coniferconifer/AIR-BENTO/README.md

## AIR BENTO CO2 and dust monitor by ESP32
## Improve Decision-Making Performance by AIR BENTO
   
### watch CO2 and dust levels at home/car/workplace , vent breathless air
- Winsen MH-Z14A CO2 sensor
- SHARP GP2Y1014AU0F dust/smoke sensor
- Bosch BMP180 pressure sensor GY-68
- Sensirion SHT21 humidity sensor GY-21  
- runs on ESP32 NodeMCU board
- 128x64 mono color OLED display is supported
- works as a MQTT client over WiFi or a BLE device
are packed in BENTO lunch box.

## what's new
- GPIO39->GPIO12 for GP2Y LED control. (GPIO39 does not work for pulse output. ) Sep 16,2018
- GPIO34->GPIO14 for SPI/SD1306. (ESP32 GPIO34-39 can not be used for OUTPUT) Sep 16,2018

- watch dog timer is introduced
- By using the latest Arduino core for ESP32 with BLE , the compiled flash memory reached 
  to 104%, so that #define BLE  at AIR-BENTO is changed to an option by default.<br>
  Update Arduino core for ESP32 WiFi chip , then use "Partition Scheme" in "Tools" menu in Arduino IDE and select "No OTA(large APP)" , 
  this program will fit in the space in case of #define BLE
  
- SHT21 humidity sensor is supported in May/14/2018 by #define HUMIDITY
  (due to i2c error , I replaced Arduino core and SHT21 library to https://github.com/stickbreaker/arduino-esp32 and 
  https://github.com/markbeee/SHT21
- GY-21 board with SHT21
- wirings are changed to use BMP180 as of April/30/2018
- #define DEEPSLEEP for ESP32 deep sleep is supported in May 13,2018

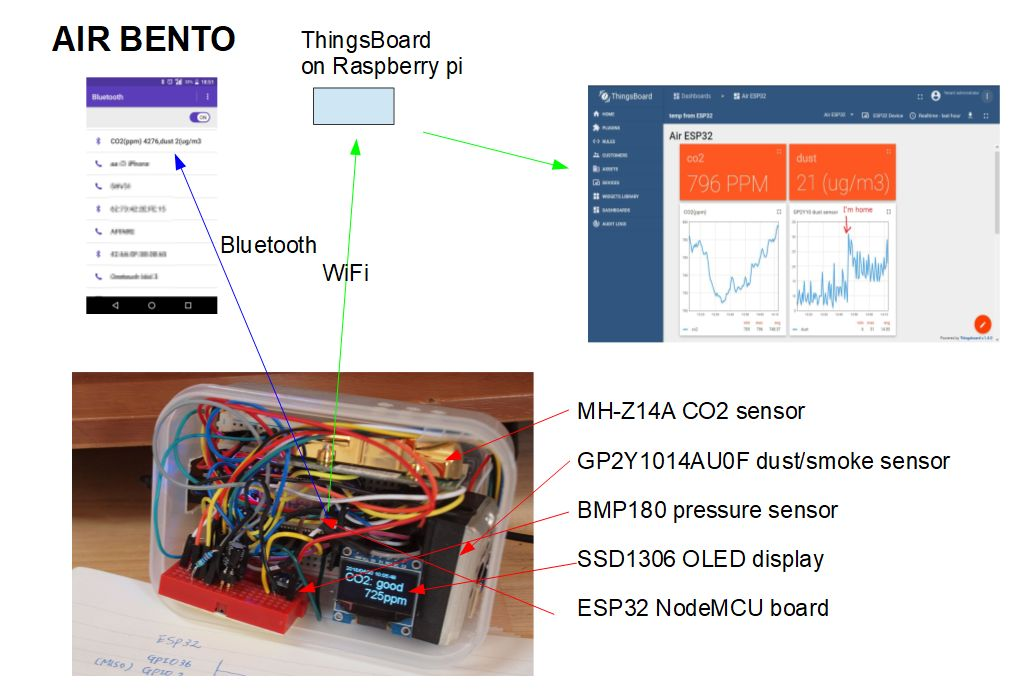
[picture p1: AIR BENTO.jpg]
Fig.1 AIR BENTO


## CO2 sensor Winsen MH-Z14A
- via 9600bps serial port

## Dust sensor SHARP GP2Y1014AU0F or maybe GP2Y1010AU0F
- analog voltage output 0-3.7V 
- Vo output is connected to ESP32 ADC33 port
- internal LED is driven by NPN transister 2N5551 from ~~GPIO39~~ GPIO_NUM_12 (Fig.2)
- max Vo output goes up to 3.7V and exceeds ESP32 max GPIO input voltage spec 3.6V , so Vo is clipped by shotkey diode 1N5819 to protect GPIO33.
  (Fig.2) , but this may be harmful to the last stage amplifier of GP2Y1016AU0F.
  <br>Voltage divider by resisters or another operational amplifier that has 0.8x gain may be better solution for product level quality.

## GY-68 BMP180 pressure sensor (Apr/30/2018)
- connected via I2C (GPIO21 as SDA , GPIO22 as SCL)
- GY-68 BMP180 has 3.3V linear regulator on board and SDA,SCL are pulled up to 3.3V,
  so, I supply 5V to VCC pin. (depending on your hardware) 

## AIR BENTO posts sensor values to MQTT server via WiFi
- ThingsBoard is recommended to visualize data by its dashboard.
  I'm running ThingsBoard on Raspberry pi.

## AIR BENTO broadcasts sensor values as bluetooth device name
- in case there is no WiFi AP available,
Mobile phone users near AIR BENTO can read out sensor values without application.

## License: Apache License v2

## References

### CO2 sensor:

- [MH-Z14A  User's Manual V1.01](http://www.winsen-sensor.com/d/files/infrared-gas-sensor/mh-z14a_co2-manual-v1_01.pdf)

- [MH-Z14A User's ManualV2.4](http://www.winsen-sensor.com/d/files/PDF/Infrared%20Gas%20Sensor/NDIR%20CO2%20SENSOR/MH-Z14%20CO2%20V2.4.pdf)

- [https://revspace.nl/MHZ19](https://revspace.nl/MHZ19)

### SSD1306 OLED display library from 
- [SSD1306 https://github.com/LilyGO/ESP32-OLED0.96-ssd1306](https://github.com/LilyGO/ESP32-OLED0.96-ssd1306)

- [http://esp-idf.readthedocs.io/en/latest/api-reference/peripherals/spi_master.html](http://esp-idf.readthedocs.io/en/latest/api-reference/peripherals/spi_master.html)

### GY-68 BMP180 pressure sensor
- [GY-68 BMP180 http://artofcircuits.com/product/bmp180-digital-barometric-sensor-module-model-gy-68](http://artofcircuits.com/product/bmp180-digital-barometric-sensor-module-model-gy-68)

### BMP180 library
- [https://github.com/adafruit/Adafruit-BMP085-Library](https://github.com/adafruit/Adafruit-BMP085-Library)

### SHT21 library (New!)
- [https://github.com/e-radionicacom/SHT21-Arduino-Library](https://github.com/e-radionicacom/SHT21-Arduino-Library)
- I got i2cCheckLineState() : invalid State sda=0 scl=1  BusInvalidState TwoWire() can't init error by recent compilation
  then , replaced Arduino-esp32 to https://github.com/stickbreaker/arduino-esp32
  and https://github.com/markbeee/SHT21
  Thanks to  https://github.com/espressif/arduino-esp32/issues/464
### PubSubClient
- [https://github.com/knolleary/pubsubclient](https://github.com/knolleary/pubsubclient)

### MQTT server with visiualization tools 
- [https://thingsboard.io/] (https://thingsboard.io/)

### Time display
- public NTP server  [https://developers.google.com/time/](https://developers.google.com/time/)

### Dust sensor:
- [https://media.digikey.com/pdf/Data%20Sheets/Sharp%20PDFs/GP2Y1014AU0F_Spec_2-6-15.pdf](https://media.digikey.com/pdf/Data%20Sheets/Sharp%20PDFs/GP2Y1014AU0F_Spec_2-6-15.pdf)

- technical detail of GP2Y10's analog front end  
[http://www.ti.com/lit/ug/tidub65c/tidub65c.pdf](http://www.ti.com/lit/ug/tidub65c/tidub65c.pdf)
- wiring<br>
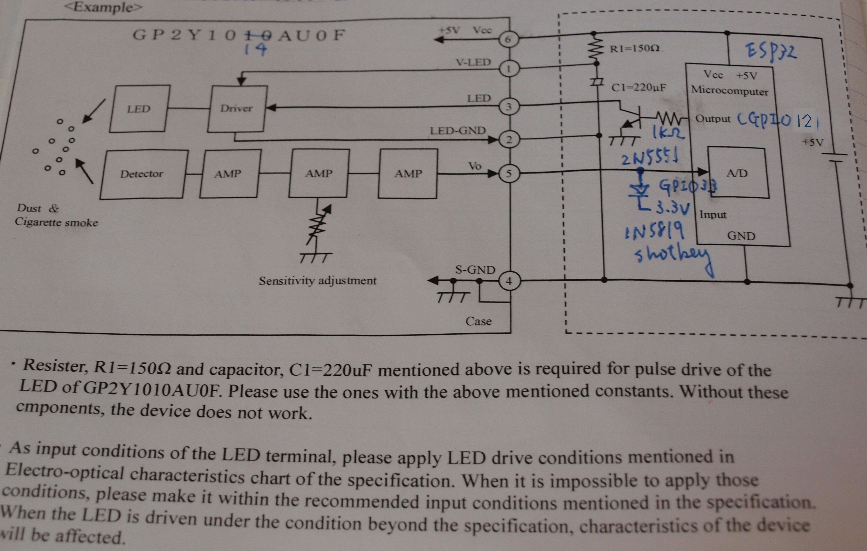
[picture p2: AIRBENTOcircuit.jpg]
Fig.2 dust sensor and ESP32


### trouble shooting:
- Why GPIO33 is used for ADC <br>
  refer to "ADC2 Channel cannot be used when WiFi is in use #440"<br>
  [https://github.com/espressif/arduino-esp32/issues/440](https://github.com/espressif/arduino-esp32/issues/440)

### remaining issues
- ~~WiFi is always ON , not good for longer battery operation.~~

### "Elevated Indoor Carbon Dioxide Impairs Decision-Making Performance"
- [http://newscenter.lbl.gov/2012/10/17/elevated-indoor-carbon-dioxide-impairs-decision-making-performance/](http://newscenter.lbl.gov/2012/10/17/elevated-indoor-carbon-dioxide-impairs-decision-making-performance/)

### "High CO2 Levels in Your Car"
- [https://www.co2meter.com/blogs/news/23987521-high-co2-levels-in-your-car](https://www.co2meter.com/blogs/news/23987521-high-co2-levels-in-your-car)
- AIR-BENTO in the car <br>
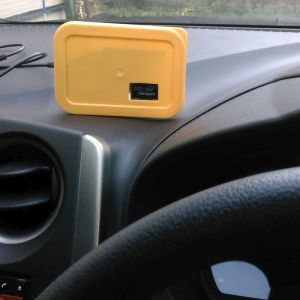
[picture p3: airbentointhecar.jpg]
Fig.3 AIR-BENTO in the car

  
### pulseview by sigrok project is quite useful 
- SHT21 I2C bus observed by CY7C68013A-56 EZ-USB FX2LP USB board<br>
  [https://sigrok.org/wiki/Lcsoft_Mini_Board](https://sigrok.org/wiki/Lcsoft_Mini_Board)
- software logic analyzer<br>
  [https://sigrok.org/wiki/PulseView](https://sigrok.org/wiki/PulseView)<br>
  SHT21 command write<br>
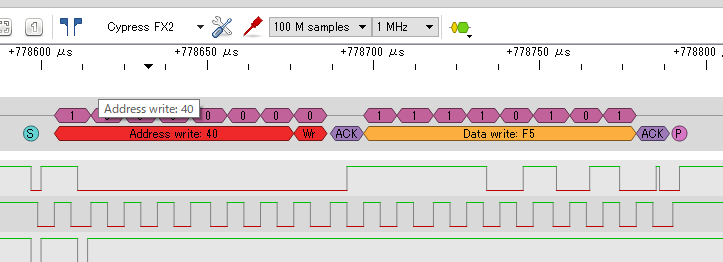
[picture p4: SHT21commandwrite.png]
Fig.4 write
  <br>
  SHT21 command read<br>
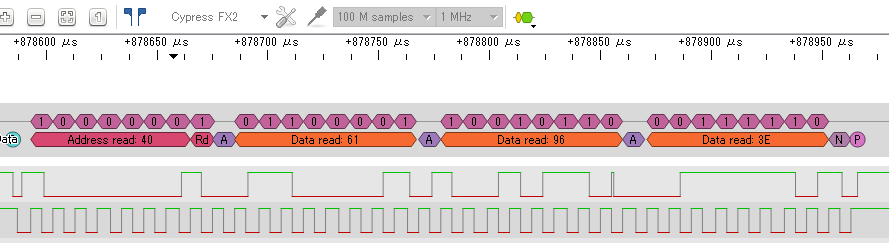
[picture p5: SHT21commandread.png]
Fig.5 read
  <br>

### CO2 measureing may be a brain activity monitor<br>
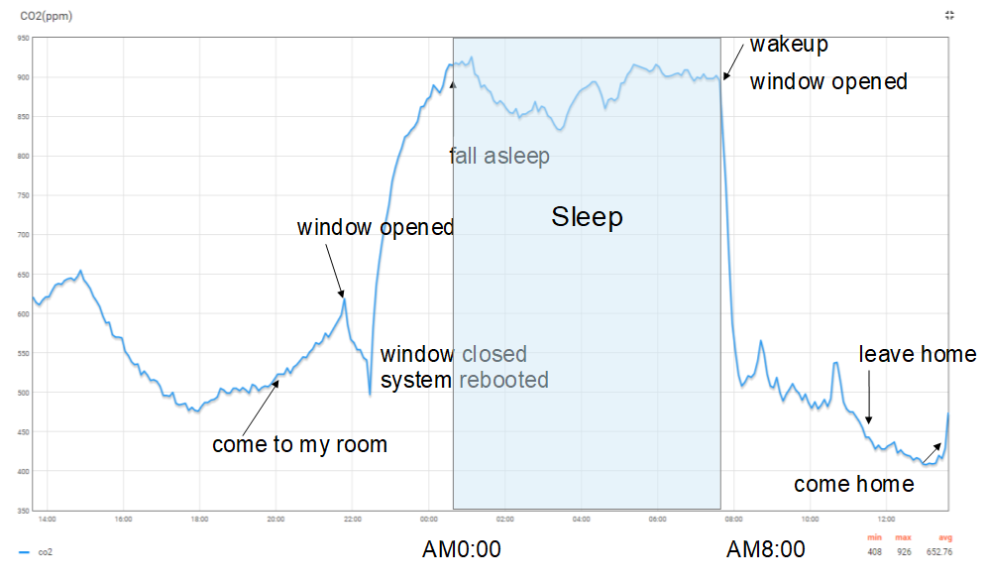
[picture p6: CO2graph.png]
Fig.6 CO2 graph
<br>

### dust sensor detects when I'm home
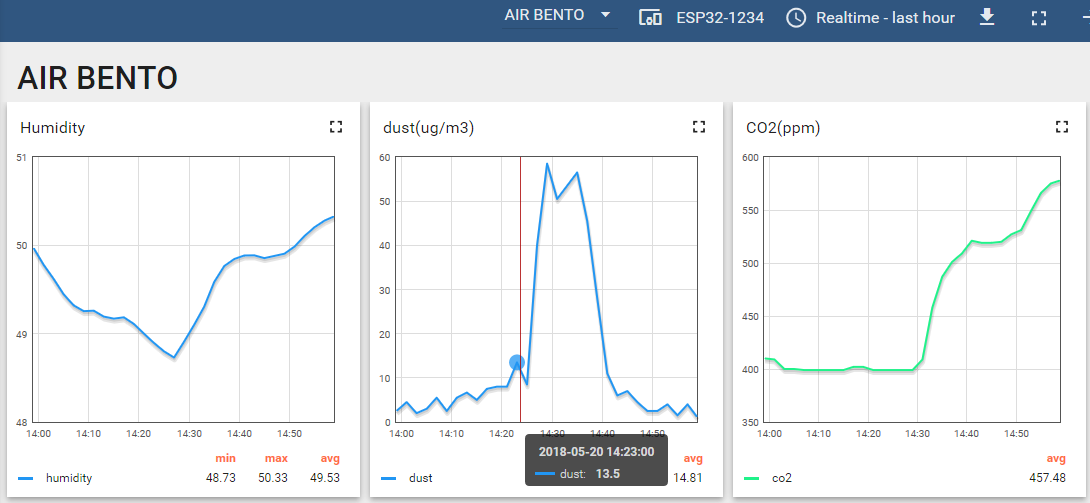
[picture p7: whenIamhome.png]
Fig.7 I'm home at around 13:23, humidity , dust and co2 level jumped!
<br>
