coniferconifer/AIR-BENTO/circuit.jpg

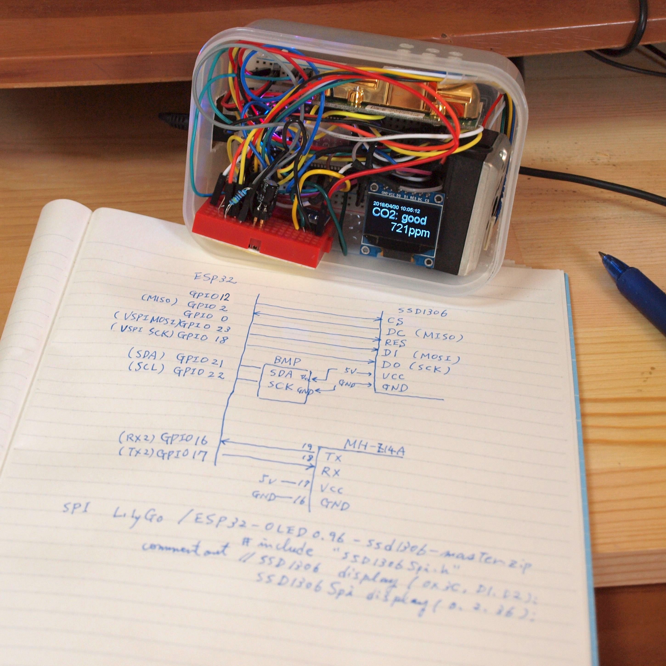
circuit.jpg
