coniferconifer/AIR-BENTO/SimpleBLE.png

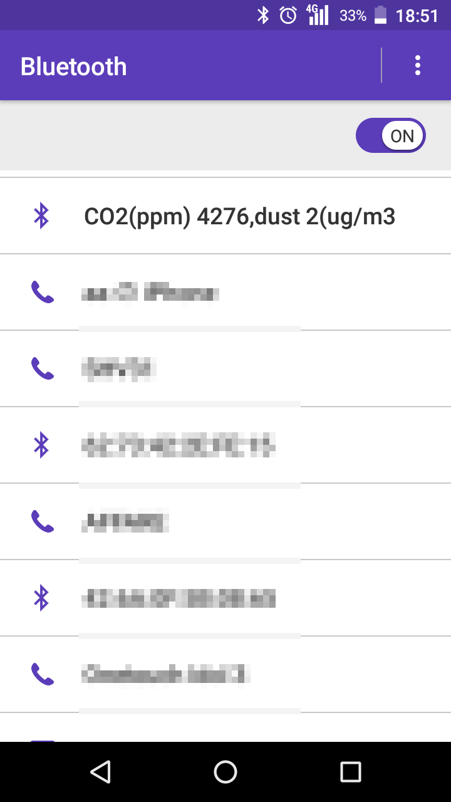
SimpleBLE.png
