coniferconifer/AIR-BENTO/(commit log)

2018-05-20 tips for I2C error
2018-05-26 GY-21 board issue is removed from README
2018-08-05 watchdog timer added
2018-08-05 watchdog timer extended
2018-09-15 GPIO39->GPIO12 for GP2Y LED
